MxFxM/LED-Pocket-Watch/README.md

# LED-Pocket-Watch
 I build a LED watch in the case of a broken pocket watch
