MxFxM/LED-Pocket-Watch/docs/Requirements.odt

Requirements

Show:

- Time
  - (Seconds, same as minutes hands)
  - Minutes 0-59
  - Hours 0-23
- Date
  - Day of month 1-31
  - Weekday 1-7
  - Month of year 1-12
  - Year 2000-2100

Others:

- Power from 2032 coin cell
- Long battery life
- RTC with 32.768kHz crystal
- Show leds while button is pressed
- Fit in pocket watch case
- Hold place in case

Circuit pieces:

- Programming header
- Boot and reset pins
- Wake-Up button
- I2C interface between ICs with pull ups
- Microcontroller IC
- LEDs
- LED driver IC
