MxFxM/LED-Pocket-Watch/docs/led-clock-schematic.pdf

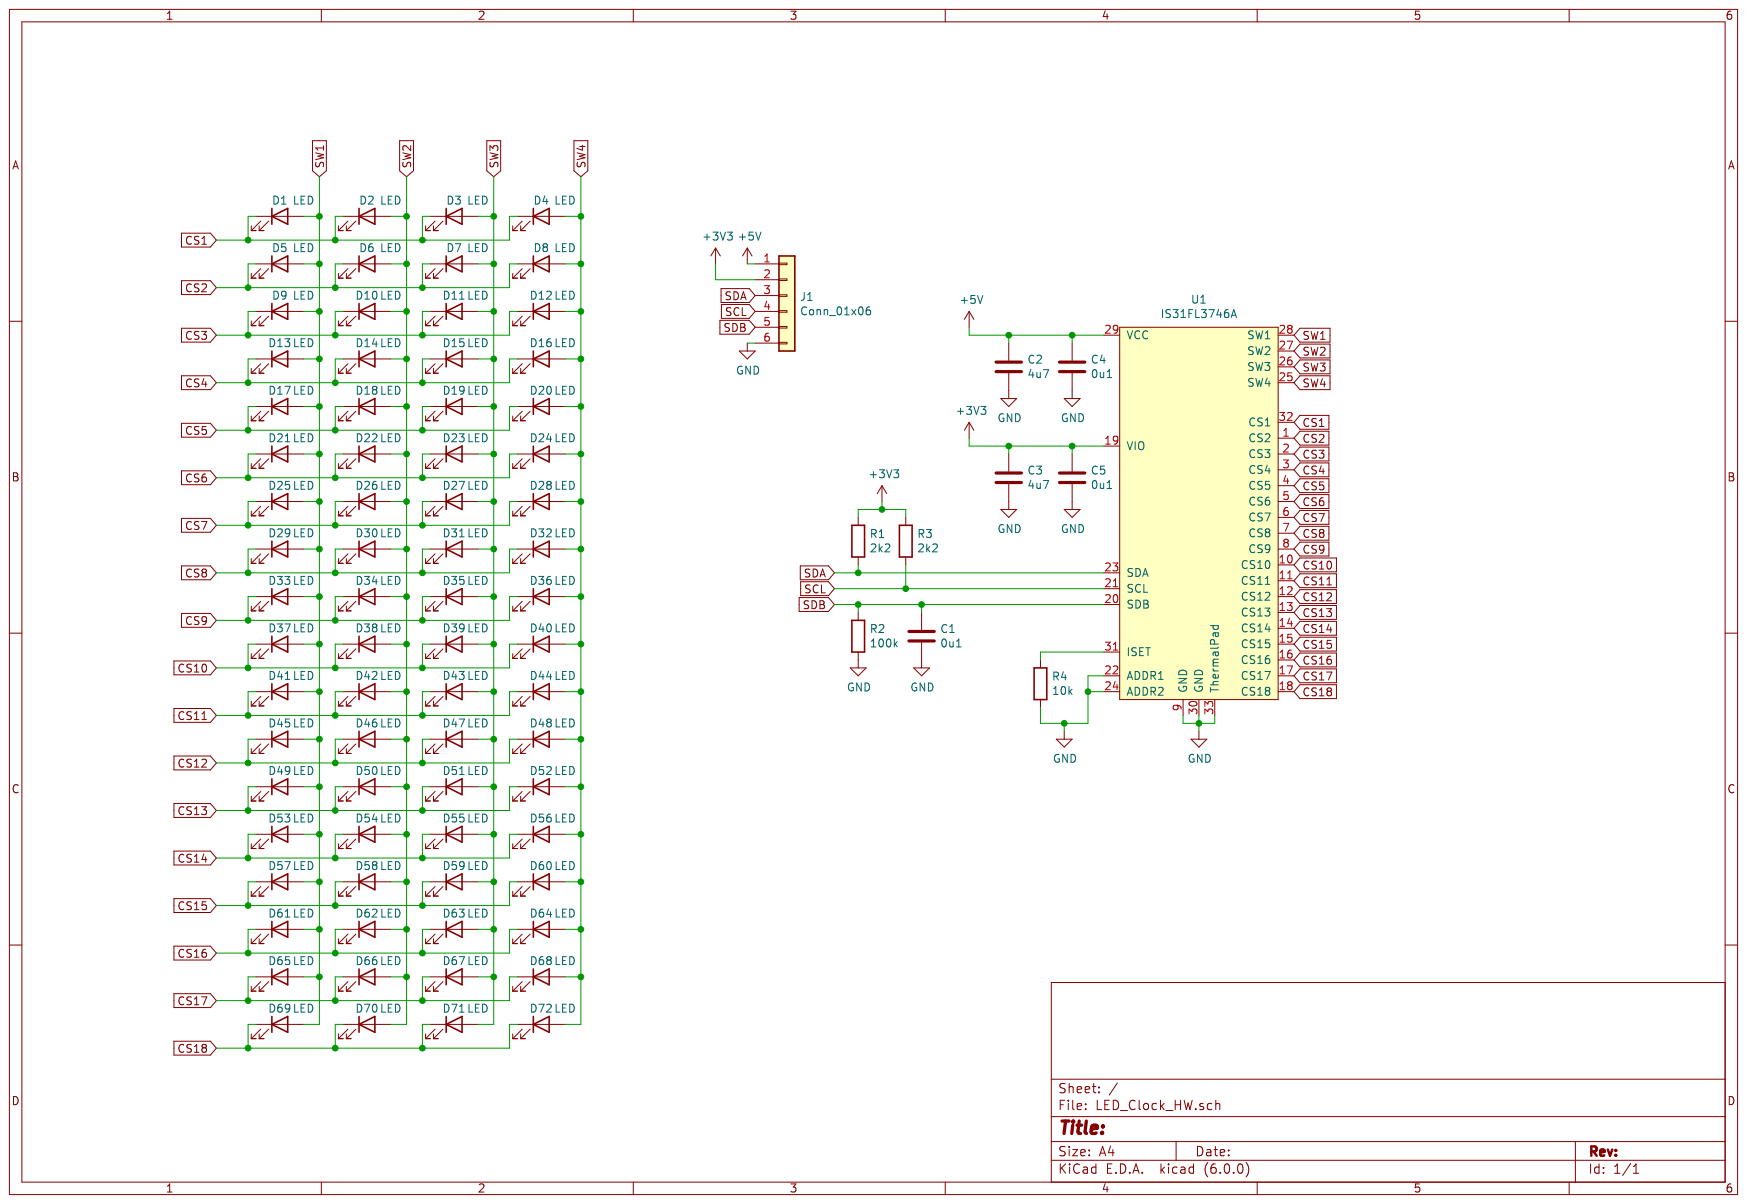
[picture p1: page 1]
