MxFxM/LED-Pocket-Watch/LED_PW_FW/STM32L031_HelloCombination/Core/Src/main.c

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
/* Includes ------------------------------------------------------------------*/
#include "main.h"

/* USER CODE BEGIN Includes */
#include "build_defs.h"
#include <stdbool.h>
/* USER CODE END Includes */

/* USER CODE BEGIN PD */
#define Addr_GND_GND 0xC0
/* USER CODE END PD */

I2C_HandleTypeDef hi2c1;

RTC_HandleTypeDef hrtc;

UART_HandleTypeDef huart2;

/* USER CODE BEGIN PV */
uint8_t hours[] = {35, 53, 71, 18, 36, 54, 72, 16, 34, 52, 70, 17};

uint8_t minutes[] = {2, 20, 38, 56,
                     3, 21, 39, 57,
                     4, 22, 40, 58,
                     5, 23, 41, 59,
                     6, 24, 42, 60,
                     7, 25, 43, 61,
                     8, 26, 44, 62,
                     9, 27, 45, 63,
                     10, 28, 46, 64,
                     11, 29, 47, 65,
                     12, 30, 48, 66,
                     13, 31, 49, 67,
                     14, 32, 50, 68,
                     15, 33, 51, 69,
                     1, 19, 37, 55};
/* USER CODE END PV */

void SystemClock_Config(void);
static void MX_GPIO_Init(void);
static void MX_USART2_UART_Init(void);
static void MX_I2C1_Init(void);
static void MX_RTC_Init(void);
/* USER CODE BEGIN PFP */
static void MAX_Set_Rtc(void);
void MAX_Init3746A(void);
void MAX_I2CSend(uint8_t * data);
/* USER CODE END PFP */

/**
  * @brief  The application entry point.
  * @retval int
  */
int main(void)
{
  /* MCU Configuration--------------------------------------------------------*/

  /* Reset of all peripherals, Initializes the Flash interface and the Systick. */
  HAL_Init();

  /* Configure the system clock */
  SystemClock_Config();

  /* Initialize all configured peripherals */
  MX_GPIO_Init();
  MX_USART2_UART_Init();
  MX_I2C1_Init();
  MX_RTC_Init();
  /* USER CODE BEGIN 2 */
  // NOTE: USER MODIFIED CODE IN AUTO CONFIG MX_RTC_Init(); !!!!!!!!!!!!!!!!!!!!!!!!

  // when coming from standby
  if (PWR->CSR & PWR_CSR_SBF) {
    // reset the standby flag
    PWR->CR |= PWR_CR_CSBF;
  } else {
    // coming from flashing (or full reset)

    MAX_Set_Rtc();
  }

  HAL_GPIO_WritePin(GPIOA, GPIO_PIN_12, GPIO_PIN_SET);
  HAL_GPIO_WritePin(GPIOA, GPIO_PIN_11, GPIO_PIN_SET);

  MAX_Init3746A();

  RTC_TimeTypeDef lasttime;
  lasttime.Seconds = 99;
  lasttime.Hours = 99;
  lasttime.Minutes = 99;

  bool changed = false;
  /* USER CODE END 2 */

  /* Infinite loop */
  /* USER CODE BEGIN WHILE */
  while (1)
  {
    RTC_TimeTypeDef time;
    RTC_DateTypeDef date;
    HAL_RTC_GetTime(&hrtc, &time, RTC_FORMAT_BIN);
    HAL_RTC_GetDate(&hrtc, &date, RTC_FORMAT_BIN);

    uint8_t data[2];
    data[0] = 0xfe;
    data[1] = 0xc5;
    MAX_I2CSend(data);
    data[0] = 0xfd;
    data[1] = 0x00;
    MAX_I2CSend(data); // page 0

    if (time.Seconds != lasttime.Seconds) {
      data[0] = minutes[(lasttime.Seconds+41)%60];
      data[1] = 0x00;
      MAX_I2CSend(data); // off

      changed = true;

      data[0] = minutes[(time.Seconds+41)%60];
      data[1] = 0x08;
      MAX_I2CSend(data); // on
      data[0] = minutes[(time.Minutes+41)%60];
      data[1] = 0x08;
      MAX_I2CSend(data); // on
    }

    if (time.Minutes != lasttime.Minutes) {
      data[0] = minutes[(lasttime.Minutes+41)%60];
      data[1] = 0x00;
      MAX_I2CSend(data); // off

      changed = true;

      data[0] = minutes[(time.Minutes+41)%60];
      data[1] = 0x08;
      MAX_I2CSend(data); // on
    }

    if (time.Hours != lasttime.Hours) {
      data[0] = hours[(lasttime.Hours+4)%12];
      data[1] = 0x00;
      MAX_I2CSend(data); // off

      changed = true;

      data[0] = hours[(time.Hours+4)%12];
      data[1] = 0x08;
      MAX_I2CSend(data); // on
    }

    if (changed) {
      changed = false;
      lasttime = time;
    }

    // if button was released, aka pulled low
    if (!HAL_GPIO_ReadPin(GPIOA, GPIO_PIN_1)) {

      // all leds off
      data[0] = 0xfe;
      data[1] = 0xc5;
      MAX_I2CSend(data);
      data[0] = 0xfd;
      data[1] = 0x00;
      MAX_I2CSend(data); // page 0
      for (int i = 1; i < 73; i++)
      {
        data[0] = i;
        data[1] = 0x00;
        MAX_I2CSend(data); // PWM
      }

      // turn stuff off
      PWR->CSR |= PWR_CSR_EWUP1 | PWR_CSR_EWUP2;
      PWR->CR |= PWR_CR_CWUF;
      PWR->CR |= PWR_CR_ULP; // turn off v_refint

      HAL_PWR_EnableWakeUpPin(PWR_WAKEUP_PIN1);

      // goto standby
      HAL_PWR_EnterSTANDBYMode();
    }
    /* USER CODE END WHILE */

    /* USER CODE BEGIN 3 */
  }
  /* USER CODE END 3 */
}

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
/* USER CODE BEGIN 4 */
static void MAX_Set_Rtc(void)
{
  // with the build_defs.h this sets the rtc to build time
  // it will lag the real time just by a few seconds

  RTC_TimeTypeDef time;
  time.Hours = BUILD_HOUR;
  time.Minutes = BUILD_MIN;
  time.Seconds = BUILD_SEC;
  HAL_RTC_SetTime(&hrtc, &time, RTC_FORMAT_BIN);

  // same with the date
  RTC_DateTypeDef date;
  date.Year = BUILD_YEAR_SHORT;
  date.Month = BUILD_MONTH;
  date.Date = BUILD_DAY;
  // the weekday is calculated (meh)
  uint16_t year = BUILD_YEAR;
  uint16_t month = BUILD_MONTH;
  uint16_t day = BUILD_DAY;
  if (month < 3) {
    day = day + year;
    year--;
  } else {
    day = day + year - 2;
  }
  date.WeekDay = ((uint16_t)(23 * month/9.0) + day + 4 + (uint16_t)(year/4) - (uint16_t)(year/100) + (uint16_t)(year/400)) % 7;
  // correct for sunday
  // 1 = monday, 7 = sunday
  if (date.WeekDay == 0) {
    date.WeekDay = 7;
  }
  HAL_RTC_SetDate(&hrtc, &date, RTC_FORMAT_BIN);
}

void MAX_Init3746A(void)
{
  uint8_t data[2];

  data[0] = 0xfe;
  data[1] = 0xc5;
  MAX_I2CSend(data);
  data[0] = 0xfd;
  data[1] = 0x00;
  MAX_I2CSend(data); // page 0
  for (int i = 1; i < 73; i++)
  {
    data[0] = i;
    data[1] = 0x00;
    MAX_I2CSend(data); // PWM
  }

  data[0] = 0xfe;
  data[1] = 0xc5;
  MAX_I2CSend(data);
  data[0] = 0xfd;
  data[1] = 0x01;
  MAX_I2CSend(data); // page 1
  for (int i = 1; i < 73; i++)
  {
    data[0] = i;
    data[1] = 0xff;
    MAX_I2CSend(data); // scaling
  }

  data[0] = 0x52;
  data[1] = 0x70;
  MAX_I2CSend(data);
  data[0] = 0x51;
  data[1] = 0xff;
  MAX_I2CSend(data); // gcc
  data[0] = 0x50;
  data[1] = 0x01;
  MAX_I2CSend(data);
}

void MAX_I2CSend(uint8_t * data)
{
  HAL_I2C_Master_Transmit(&hi2c1, Addr_GND_GND, data, 2, 0xFFFF);
}
/* USER CODE END 4 */
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
