MxFxM/LED-Pocket-Watch/LED_PW_FW/STM32L031_HelloStandby/STM32L031_HelloStandby.ioc

Mcu.UserName=STM32L031K6Tx
PA0-CK_IN.Signal=SYS_WKUP1
PA1.Signal=GPIO_Input
PA13.GPIO_Label=TMS
PA13.Signal=SYS_SWDIO
PA14.GPIO_Label=TCK
PA14.Signal=SYS_SWCLK
PA15.GPIO_Label=VCP_RX
PA15.Signal=USART2_RX
PA2.GPIO_Label=VCP_TX
PA2.Signal=USART2_TX
PB3.GPIO_Label=LD3 [Green]
PB3.Signal=GPIO_Output
PC14-OSC32_IN.Signal=RCC_OSC32_IN
PC15-OSC32_OUT.Signal=RCC_OSC32_OUT
