MxFxM/LED-Pocket-Watch/LED_PW_FW/STM32L031_HelloCombination/Core/Inc/main.h

#define VCP_TX_Pin GPIO_PIN_2
#define VCP_TX_GPIO_Port GPIOA
#define TMS_Pin GPIO_PIN_13
#define TMS_GPIO_Port GPIOA
#define TCK_Pin GPIO_PIN_14
#define TCK_GPIO_Port GPIOA
#define VCP_RX_Pin GPIO_PIN_15
#define VCP_RX_GPIO_Port GPIOA
#define LD3_Pin GPIO_PIN_3
#define LD3_GPIO_Port GPIOB
