MxFxM/LED-Pocket-Watch/(commit log)

2022-01-01 created kicad project for hardware
2022-01-01 casing measurements
    [LED_PW_HW.kicad_pcb]
2022-01-01 created footprints for battery holder and led driver
2022-01-01 led matrix as in datasheet of driver
    [LED_PW_HW.kicad_sch, controller.kicad_sch, led_matrix.kicad_sch]
2022-01-01 created footprint for battery holder and led driver
2022-01-01 imported first footprints to pcb to get an idea
    [LED_PW_HW.kicad_pcb, LED_PW_HW.kicad_sch, controller.kicad_sch, led_matrix.kicad_sch]
2022-01-02 experimenting with plugin
    [LED_PW_HW.kicad_pcb]
2022-01-02 sorting the leds
    [LED_PW_HW.kicad_pcb]
2022-01-02 sorted leds
    [LED_PW_HW.kicad_pcb]
2022-01-03 hello world with rtc on stm32l031k6 nucleo
2022-01-04 i2c test
2022-01-06 schematic of led driver part done
    [LED_PW_HW.kicad_pcb, LED_PW_HW.kicad_sch, controller.kicad_sch, led_matrix.kicad_sch]
2022-01-06 controller schematic part done
    [LED_PW_HW.kicad_pcb, LED_PW_HW.kicad_sch, controller.kicad_sch]
2022-01-06 led placement
    [LED_PW_HW.kicad_pcb]
2022-01-06 giving up for now and going with 72 leds
    [LED_PW_HW.csv, LED_PW_HW.kicad_pcb, LED_PW_HW.kicad_sch, controller.kicad_sch, led_matrix.kicad_sch]
2022-01-11 backup changes
    [LED_PW_HW.csv, LED_PW_HW.kicad_pcb, LED_PW_HW.kicad_sch, controller.kicad_sch, led_matrix.kicad_sch]
2022-01-11 new version
    [LED_PW_HW.csv, LED_PW_HW.kicad_pcb, LED_PW_HW.kicad_sch, controller.kicad_sch, led_matrix.kicad_sch]
2022-01-15 v3 is a cleaner v1
    [LED_PW_HW.csv, LED_PW_HW.kicad_pcb, LED_PW_HW.kicad_sch, controller.kicad_sch, led_matrix.kicad_sch]
2022-01-20 hey, v1 actually runs
    but not on a button cell, because the led driver needs higher voltage. i use a lipo cell with a diode to drop the voltge by 0.7v
    [LED_PW_HW.csv, LED_PW_HW.kicad_pcb, LED_PW_HW.kicad_sch, controller.kicad_sch, led_matrix.kicad_sch]
