MxFxM/LED-Pocket-Watch/(notices)

Notices in the files:
LED_PW_FW/STM32L031_HelloCombination/Core/Inc/main.h:
Copyright (c) 2022 STMicroelectronics.
All rights reserved.
This software is licensed under terms that can be found in the LICENSE file
